RocaPiedra/RocBot/Diagrams/esp32-wroom-32d-usbc-pinout.png

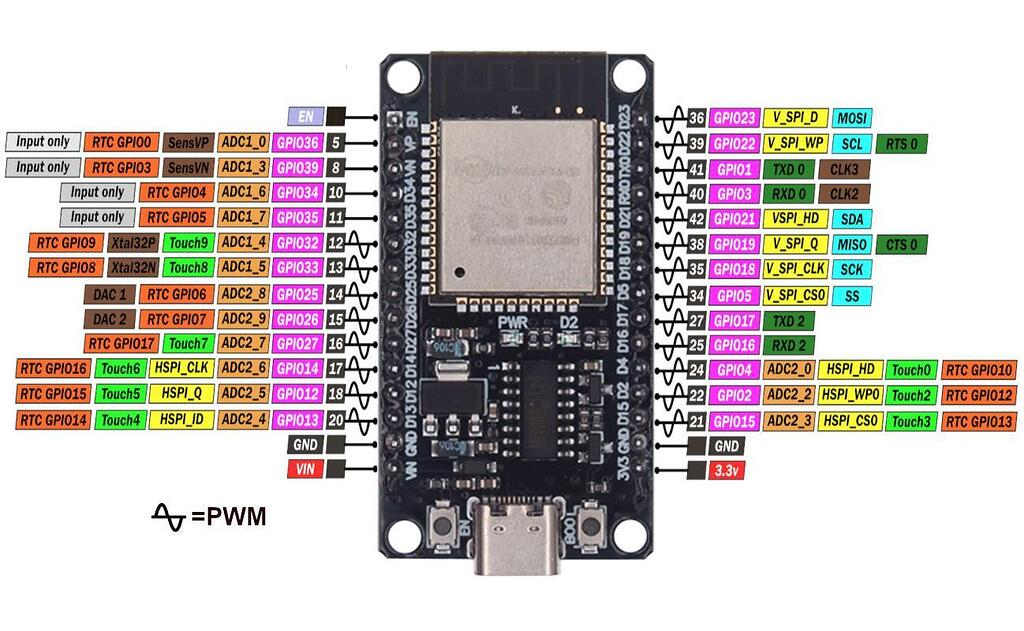
Diagrams/esp32-wroom-32d-usbc-pinout.png
