RocaPiedra/RocBot/Diagrams/L298N_conexiones.jpg

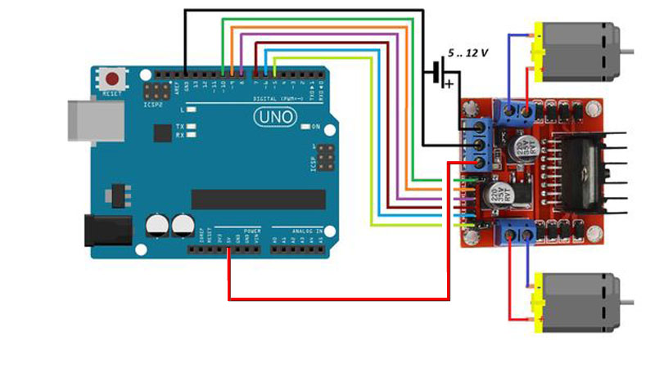
Diagrams/L298N_conexiones.jpg
