RocaPiedra/RocBot/Diagrams/L298N-Motor-Driver-Module-Pinout.png

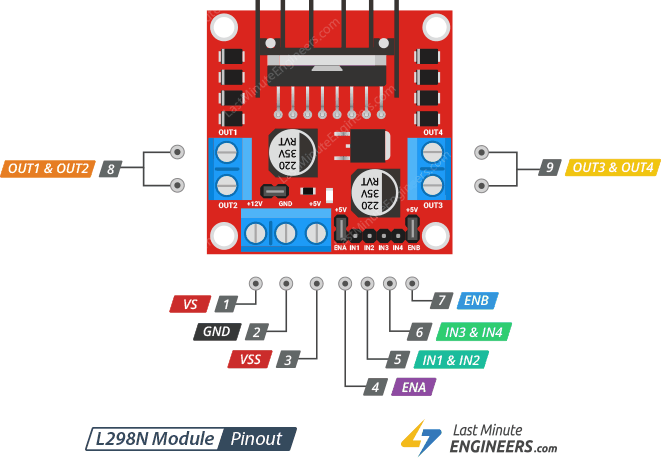
Diagrams/L298N-Motor-Driver-Module-Pinout.png
