RocaPiedra/RocBot/Diagrams/MotorWithEncoder.png

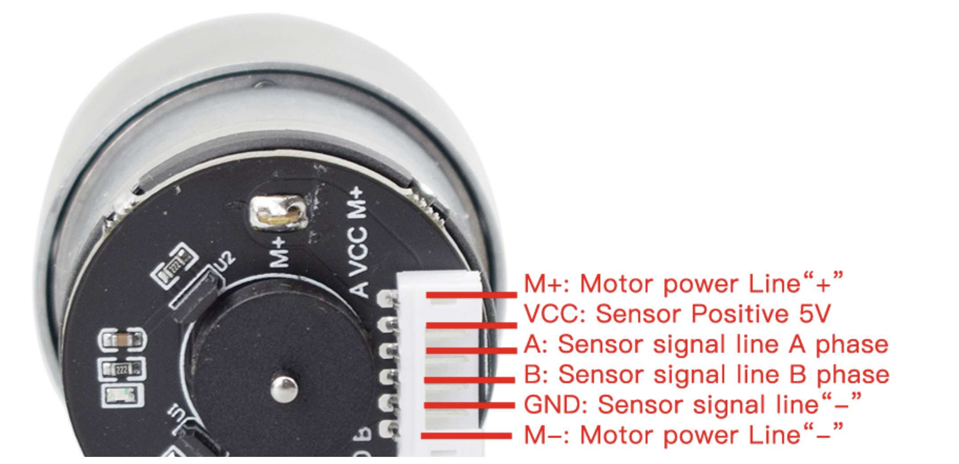
Diagrams/MotorWithEncoder.png
