RocaPiedra/RocBot/Tests/Motors/graphs/50HzRefreshRate.png

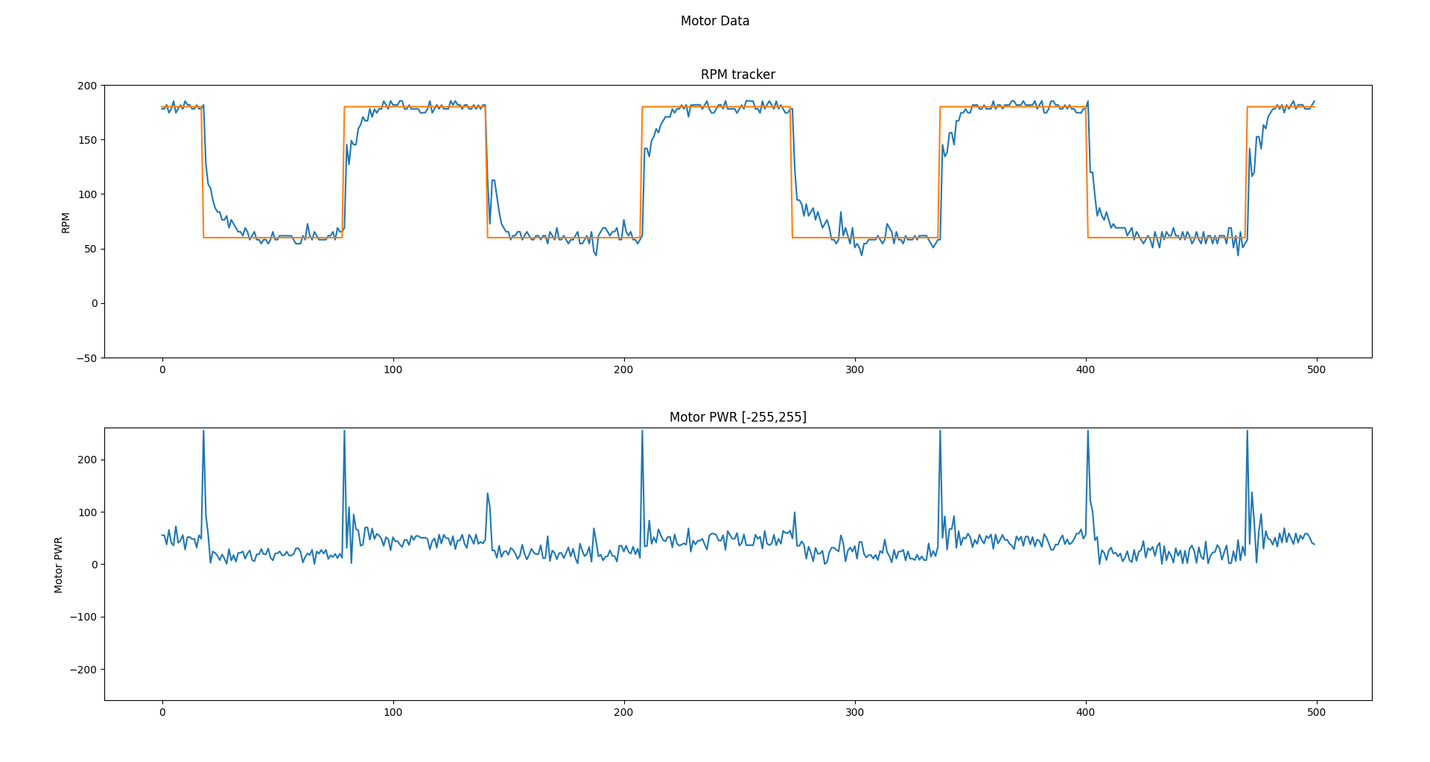
Tests/Motors/graphs/50HzRefreshRate.png
