RocaPiedra/RocBot/Tests/Motors/graphs/InputSignalInFunction.png

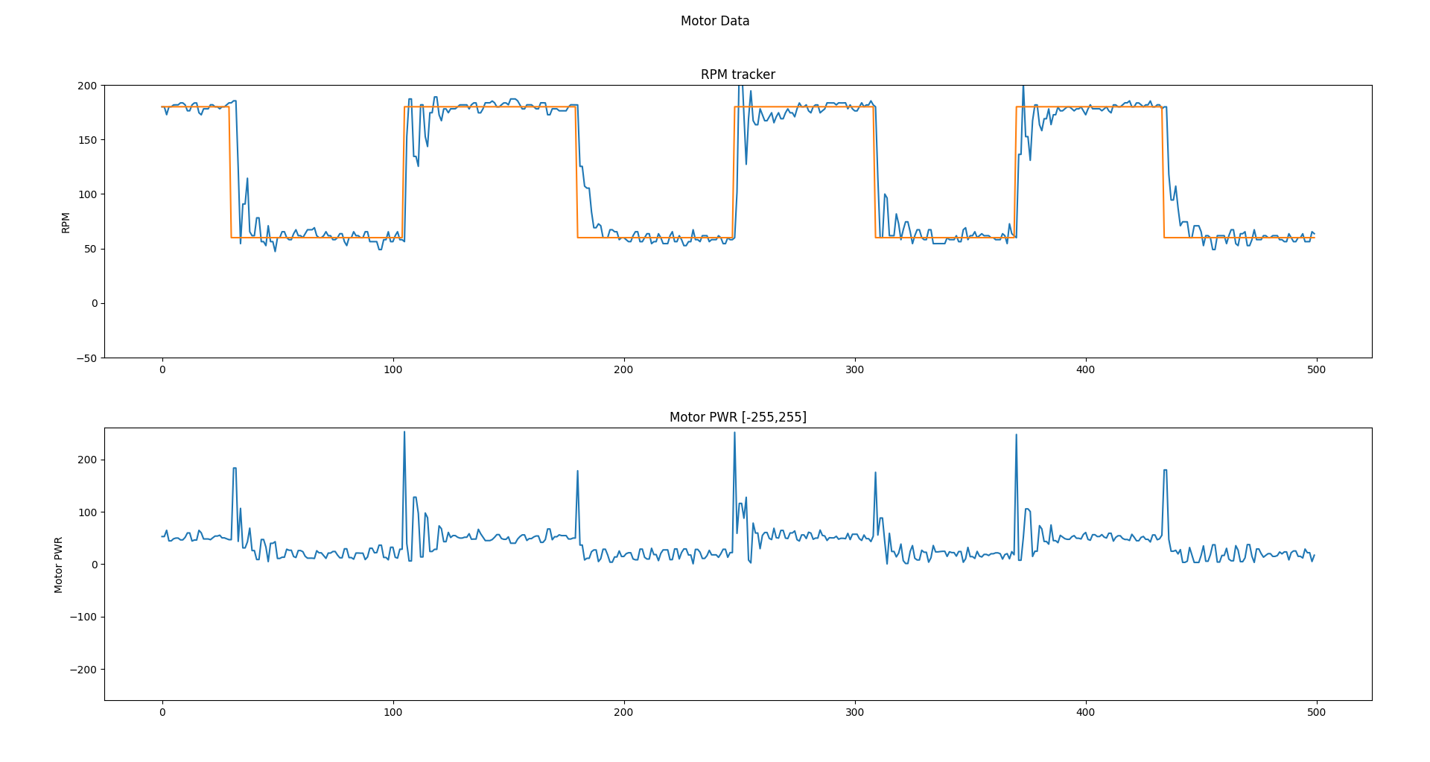
Tests/Motors/graphs/InputSignalInFunction.png
