RocaPiedra/RocBot/Tests/Motors/graphs/InputSignalInLoop.png

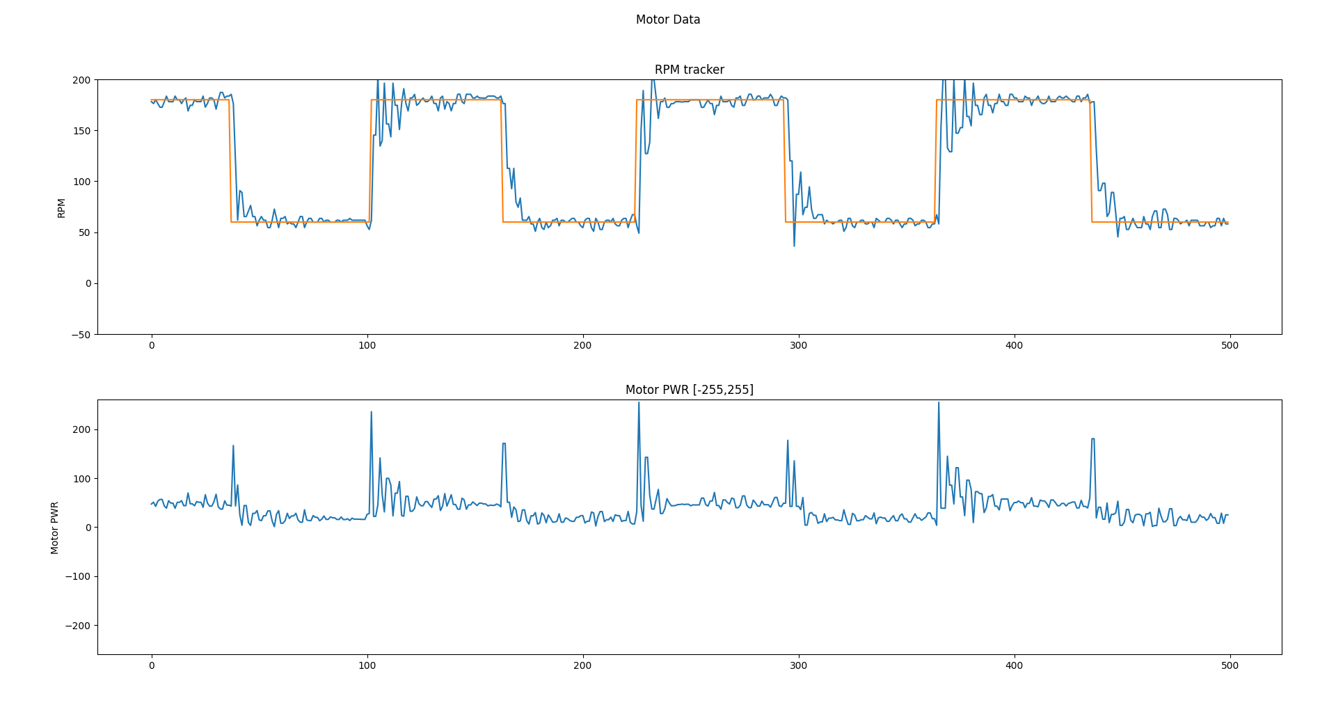
Tests/Motors/graphs/InputSignalInLoop.png
