RocaPiedra/RocBot/Tests/Motors/graphs/PID Calibration/kp0.8-ki1-kd0.1.png

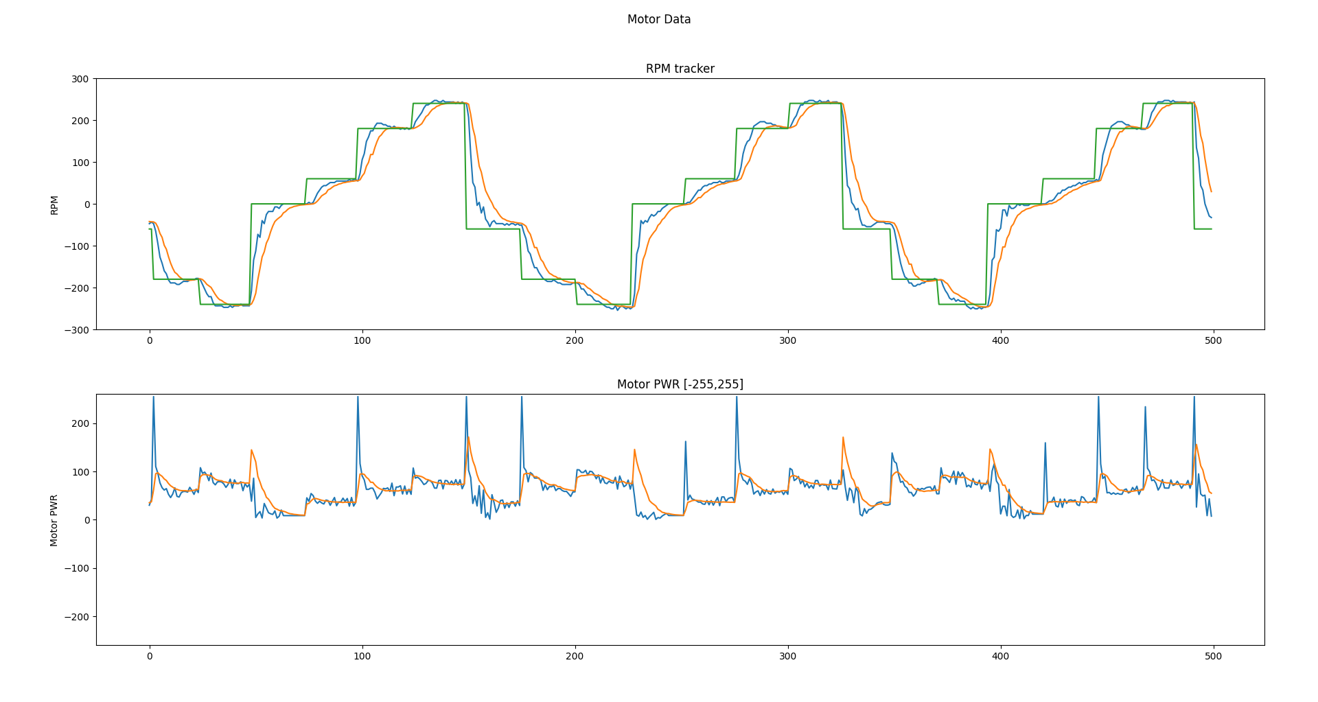
Tests/Motors/graphs/PID Calibration/kp0.8-ki1-kd0.1.png
