RocaPiedra/RocBot/Tests/Motors/graphs/PID Calibration/kp1-ki1-kd0.1.png

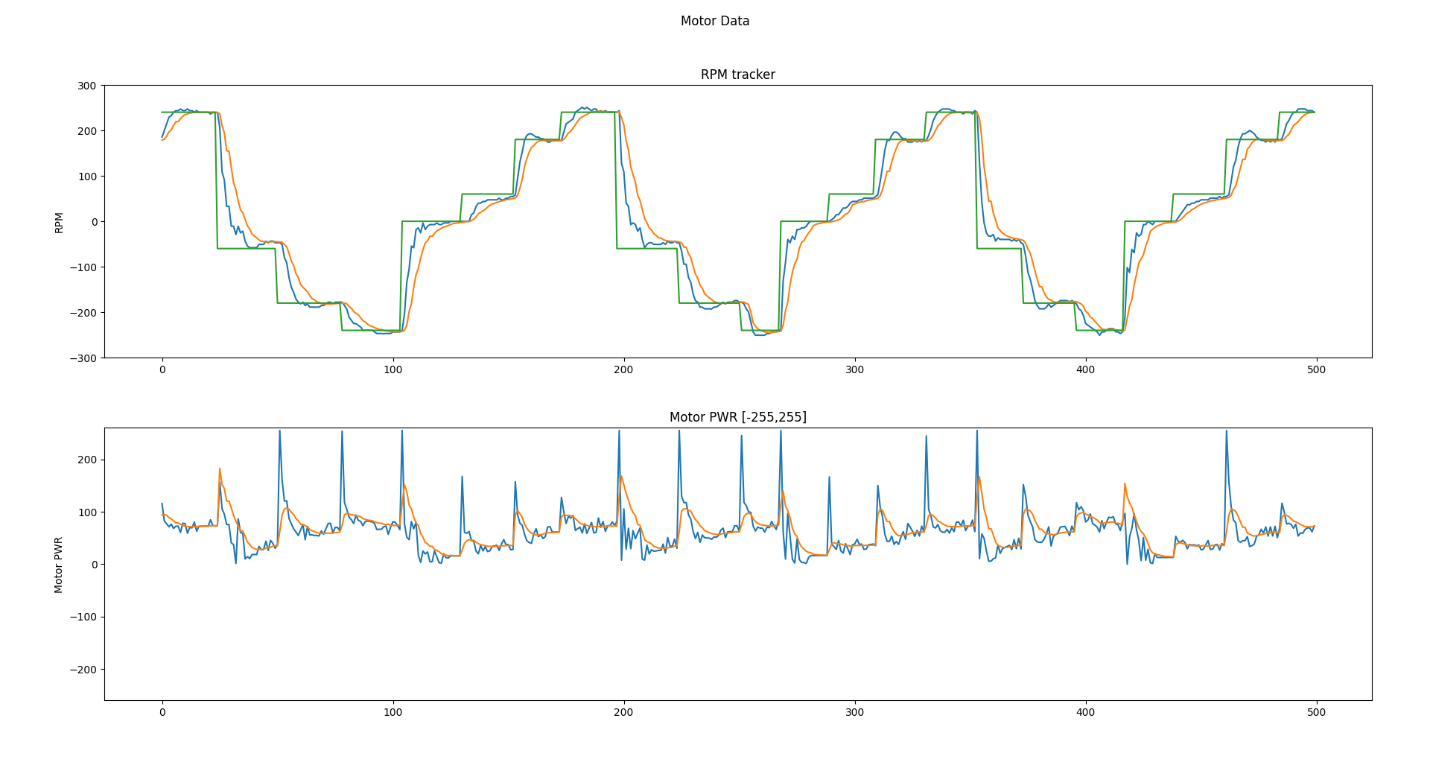
Tests/Motors/graphs/PID Calibration/kp1-ki1-kd0.1.png
