RocaPiedra/RocBot/Tests/Motors/graphs/PID Calibration/kp2-ki1-kd0.1.png

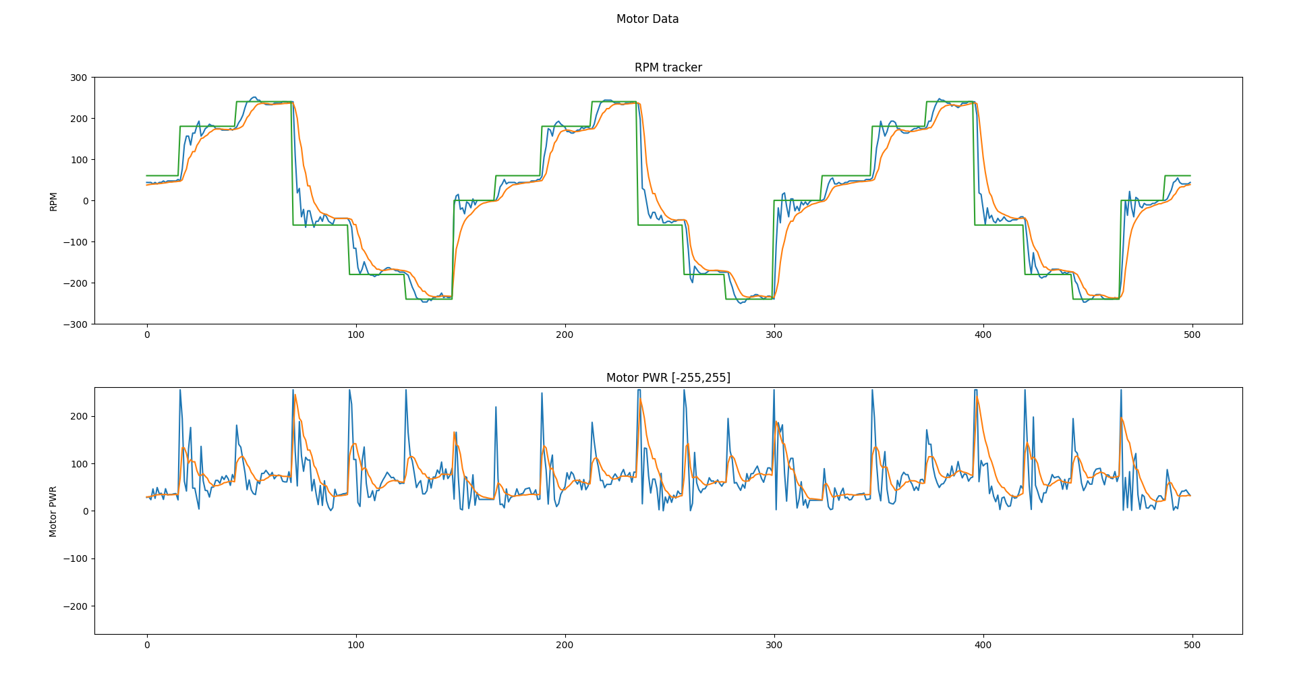
Tests/Motors/graphs/PID Calibration/kp2-ki1-kd0.1.png
