RocaPiedra/RocBot/Tests/Motors/graphs/pwr_rpm_filtered.png

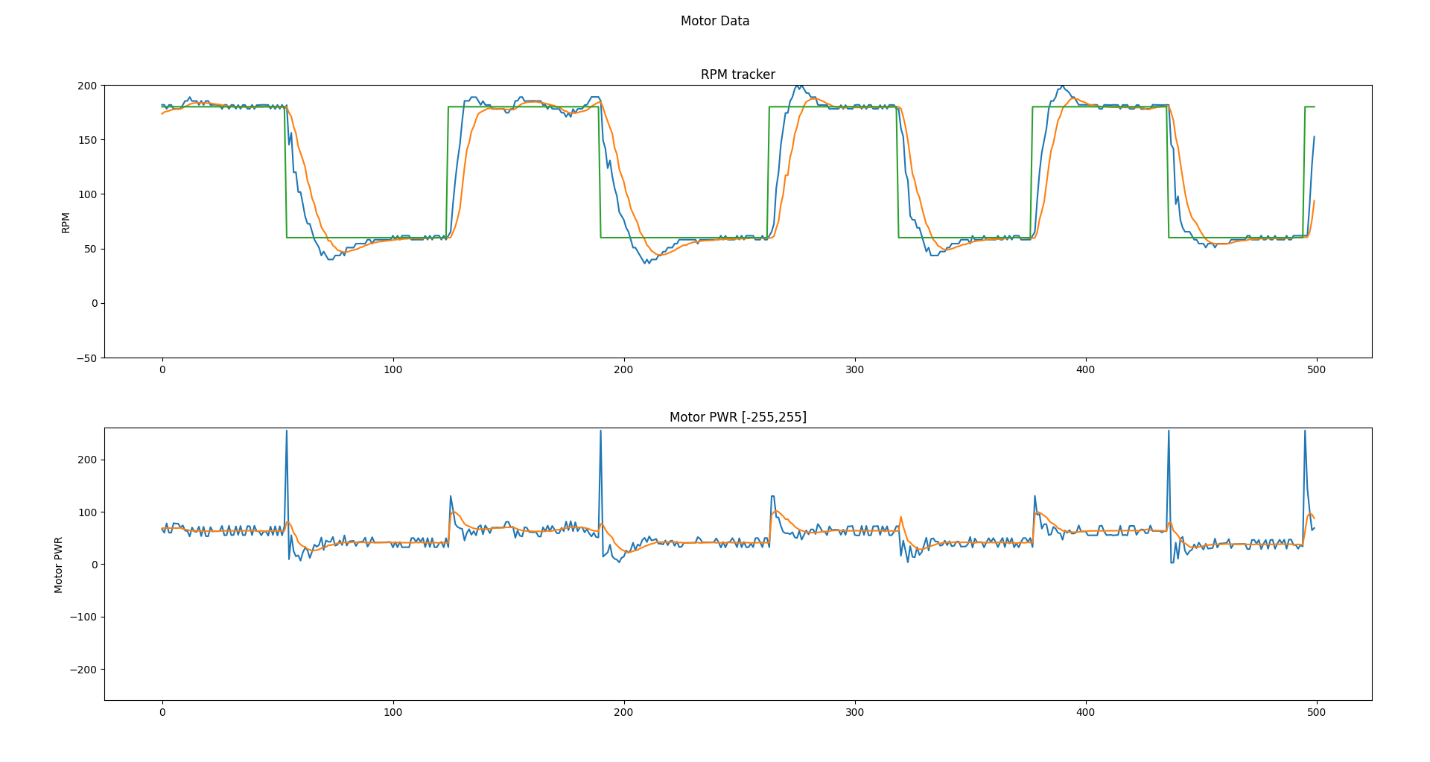
Tests/Motors/graphs/pwr_rpm_filtered.png
