RocaPiedra/RocBot/Tests/Motors/graphs/pwr_rpm_unfiltered.png

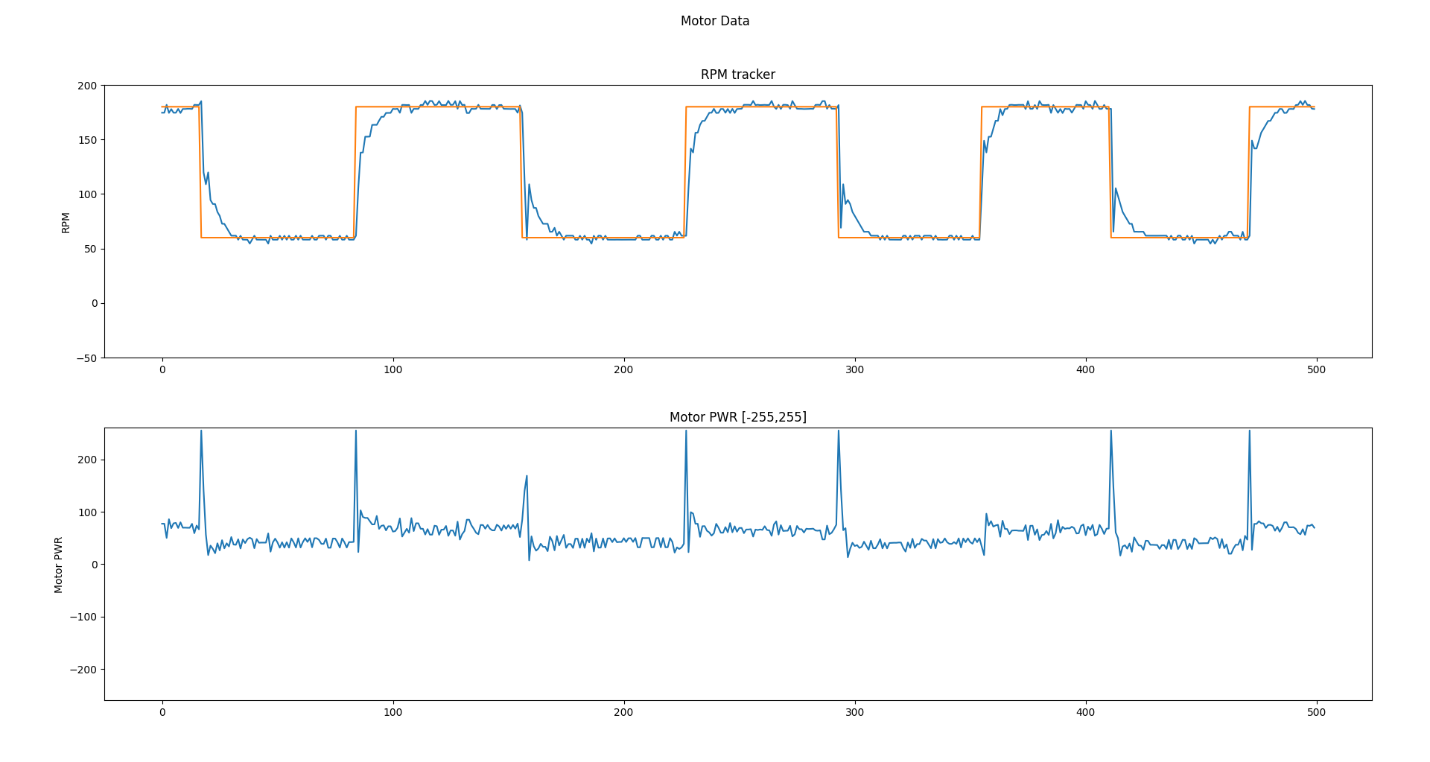
Tests/Motors/graphs/pwr_rpm_unfiltered.png
