RocaPiedra/RocBot/Tests/Motors/graphs/pwr_unfiltered_rpm_filtered.png

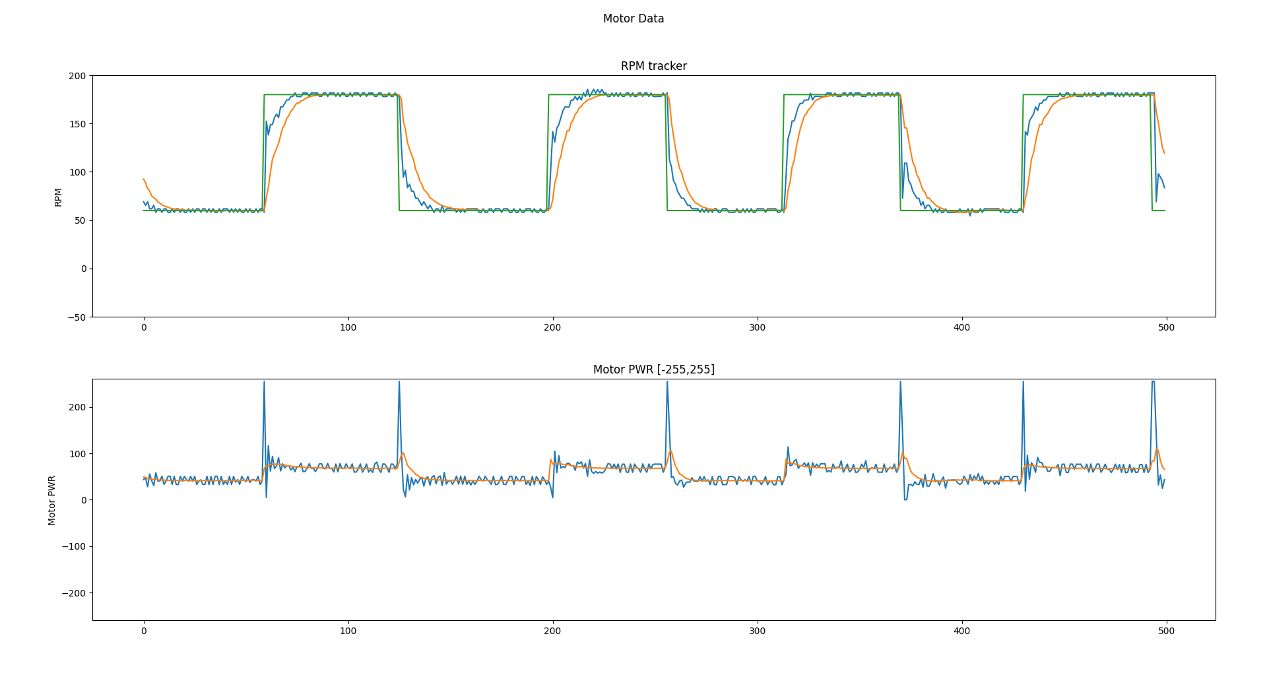
Tests/Motors/graphs/pwr_unfiltered_rpm_filtered.png
