RocaPiedra/RocBot/ESP32/ESP32WiFiConnect/src/main_microros.cpp

/*
 * RocBot ESP32 Motor Controller with micro-ROS (WiFi transport)
 *
 * Official micro_ros_platformio integration over WiFi/UDP.
 *
 * ROS 2 Topics:
 *   Subscribers:
 *     - /rocbot/motor_fl/target_rpm (std_msgs/Float64)
 *     - /rocbot/motor_fr/target_rpm (std_msgs/Float64)
 *     - /rocbot/motor_rl/target_rpm (std_msgs/Float64)
 *     - /rocbot/motor_rr/target_rpm (std_msgs/Float64)
 *     - /rocbot/motor_fl/target_pwm (std_msgs/Float64)   - Direct PWM (-255..255)
 *     - /rocbot/motor_fr/target_pwm (std_msgs/Float64)   - Direct PWM (-255..255)
 *     - /rocbot/motor_rl/target_pwm (std_msgs/Float64)   - Direct PWM (-255..255)
 *     - /rocbot/motor_rr/target_pwm (std_msgs/Float64)   - Direct PWM (-255..255)
 *     - /rocbot/command (std_msgs/String)
 *
 *   Publishers:
 *     - /rocbot/motor_fl/rpm (std_msgs/Float64)
 *     - /rocbot/motor_fl/pwm (std_msgs/Float64)
 *     - /rocbot/motor_fr/rpm (std_msgs/Float64)
 *     - /rocbot/motor_fr/pwm (std_msgs/Float64)
 *     - /rocbot/motor_rl/rpm (std_msgs/Float64)
 *     - /rocbot/motor_rl/pwm (std_msgs/Float64)
 *     - /rocbot/motor_rr/rpm (std_msgs/Float64)
 *     - /rocbot/motor_rr/pwm (std_msgs/Float64)
 *     - /rocbot/debug (std_msgs/String)
 *
 * Serial fallback: same commands as main_debug.cpp (local debug)
 *
 * Build:
 *   pio run -e microros -t upload    # Build and flash
 *   pio run -e microros --target clean_microros  # Force rebuild
 *
 * Agent (on host PC):
 *   docker run -it --rm --net=host microros/micro-ros-agent:humble udp4 --port 8888 -v6
 *
 * WiFi transport uses board_microros_transport = wifi in platformio.ini.
 * Update AGENT_IP in include/ssid.hpp to match your host PC's IP.
 */

#include <Arduino.h>
#include "MotorController.hpp"
#include "PIDClass.hpp"
#include "ssid.hpp"

// micro-ROS includes (provided by micro_ros_platformio)
#include <micro_ros_platformio.h>
#include <rcl/rcl.h>
#include <rclc/rclc.h>
#include <rclc/executor.h>
#include <std_msgs/msg/float64.h>
#include <std_msgs/msg/string.h>

// ============== Motor Configuration ==============
#define MAXCPR 330
#define MAXRPM 330
#define REFRESHRATE 5 // ms
#define NUMMOTORS 4   // FL, FR, RL, RR

#define AGENT_WAIT_MS 3000

// Pin assignments (ESP32) — see AGENTS.md
// L298N #1 (front): FL + FR | L298N #2 (rear): RL + RR
MotorController MotorFL("FL", 32, 35, 34, 33, 25, 1.0, 0.0, 0.0);
MotorController MotorFR("FR", 14, 22, 23, 27, 26, 1.0, 0.0, 0.0);
MotorController MotorRL("RL", 13, 16, 17, 4, 5, 1.0, 0.0, 0.0);
MotorController MotorRR("RR", 18, 36, 39, 19, 21, 1.0, 0.0, 0.0);

MotorController* motors[NUMMOTORS] = {&MotorFL, &MotorFR, &MotorRL, &MotorRR};

long prevT[NUMMOTORS] = {0, 0, 0, 0};
int target_value = 0;
bool pid_enabled = false;
bool direct_mode = false;
int direct_pwm = 0;
bool reverse_direct = false;

// Test mode
bool step_test_mode = false;
unsigned long step_test_start = 0;
int step_test_target = 0;

unsigned long lastDebugPrint = 0;
unsigned long debugPrintInterval = 100;

volatile unsigned long encFR_interrupts = 0;
volatile unsigned long encFL_interrupts = 0;
volatile unsigned long encRL_interrupts = 0;
volatile unsigned long encRR_interrupts = 0;

bool microros_connected = false;
unsigned long last_agent_check = 0;

// ============== ISR Handlers ==============
void IRAM_ATTR ISRReadEncoderFR() {
    MotorFR.readEncoder();
    encFR_interrupts++;
}

void IRAM_ATTR ISRReadEncoderFL() {
    MotorFL.readEncoder();
    encFL_interrupts++;
}

void IRAM_ATTR ISRReadEncoderRL() {
    MotorRL.readEncoder();
    encRL_interrupts++;
}

void IRAM_ATTR ISRReadEncoderRR() {
    MotorRR.readEncoder();
    encRR_interrupts++;
}

// ============== micro-ROS Variables ==============
rcl_node_t node;
rclc_executor_t executor;
rclc_support_t support;
rcl_allocator_t allocator;

// Subscribers
rcl_subscription_t sub_fl_target;
rcl_subscription_t sub_fr_target;
rcl_subscription_t sub_rl_target;
rcl_subscription_t sub_rr_target;
rcl_subscription_t sub_fl_pwm_cmd;
rcl_subscription_t sub_fr_pwm_cmd;
rcl_subscription_t sub_rl_pwm_cmd;
rcl_subscription_t sub_rr_pwm_cmd;
rcl_subscription_t sub_command;

// Publishers (using simple Float64 instead of Float64MultiArray for ESP32 reliability)
rcl_publisher_t pub_fl_rpm;
rcl_publisher_t pub_fl_pwm;
rcl_publisher_t pub_fr_rpm;
rcl_publisher_t pub_fr_pwm;
rcl_publisher_t pub_rl_rpm;
rcl_publisher_t pub_rl_pwm;
rcl_publisher_t pub_rr_rpm;
rcl_publisher_t pub_rr_pwm;
rcl_publisher_t pub_debug;

// Messages
std_msgs__msg__Float64 msg_fl_rpm;
std_msgs__msg__Float64 msg_fl_pwm;
std_msgs__msg__Float64 msg_fr_rpm;
std_msgs__msg__Float64 msg_fr_pwm;
std_msgs__msg__Float64 msg_rl_rpm;
std_msgs__msg__Float64 msg_rl_pwm;
std_msgs__msg__Float64 msg_rr_rpm;
std_msgs__msg__Float64 msg_rr_pwm;
std_msgs__msg__String msg_command;
std_msgs__msg__String msg_debug;
std_msgs__msg__Float64 msg_fl_target;
std_msgs__msg__Float64 msg_fr_target;
std_msgs__msg__Float64 msg_rl_target;
std_msgs__msg__Float64 msg_rr_target;
std_msgs__msg__Float64 msg_fl_pwm_cmd;
std_msgs__msg__Float64 msg_fr_pwm_cmd;
std_msgs__msg__Float64 msg_rl_pwm_cmd;
std_msgs__msg__Float64 msg_rr_pwm_cmd;

// State buffers
char debug_buffer[768];
char command_buffer[256];

// Incoming ROS targets
float ros_target_fl = 0.0;
float ros_target_fr = 0.0;
float ros_target_rl = 0.0;
float ros_target_rr = 0.0;
bool ros_targets_active = false;

// Per-motor direct PWM (from ROS topics)
int direct_pwm_fl = 0;
int direct_pwm_fr = 0;
int direct_pwm_rl = 0;
int direct_pwm_rr = 0;
bool direct_mode_fl = false;
bool direct_mode_fr = false;
bool direct_mode_rl = false;
bool direct_mode_rr = false;
bool reverse_direct_fl = false;
bool reverse_direct_fr = false;
bool reverse_direct_rl = false;
bool reverse_direct_rr = false;

void clearPerMotorDirect() {
    direct_mode_fl = false; direct_mode_fr = false;
    direct_mode_rl = false; direct_mode_rr = false;
}

// ============== Serial Input (same as main_debug.cpp) ==============
void readSerialInput() {
    if (Serial.available() > 0) {
        String input = Serial.readStringUntil('\n');
        input.trim();

        if (input.length() == 0) return;

        char firstChar = input.charAt(0);

        if (input.startsWith("kp")) {
            float val = input.substring(2).toFloat();
            for (int i = 0; i < NUMMOTORS; i++) motors[i]->PID.kp = val;
            Serial.print("Kp set to: "); Serial.println(val);
            return;
        }
        if (input.startsWith("ki")) {
            float val = input.substring(2).toFloat();
            for (int i = 0; i < NUMMOTORS; i++) motors[i]->PID.ki = val;
            Serial.print("Ki set to: "); Serial.println(val);
            return;
        }
        if (input.startsWith("kd")) {
            float val = input.substring(2).toFloat();
            for (int i = 0; i < NUMMOTORS; i++) motors[i]->PID.kd = val;
            Serial.print("Kd set to: "); Serial.println(val);
            return;
        }
        if (input.startsWith("os")) {
            float val = input.substring(2).toFloat();
            for (int i = 0; i < NUMMOTORS; i++) motors[i]->PID.output_scale = val;
            Serial.print("Output scale set to: "); Serial.println(val);
            return;
        }
        if (input.startsWith("step")) {
            int val = input.substring(4).toInt();
            step_test_mode = true;
            step_test_target = val;
            step_test_start = millis();
            target_value = 0;
            pid_enabled = true;
            direct_mode = false;
            clearPerMotorDirect();
            Serial.print("Step test starting: target "); Serial.println(val);
            return;
        }

        switch(firstChar) {
            case 'g': {
                Serial.println("--- MOTOR STATE ---");
                Serial.print("Kp="); Serial.print(motors[0]->PID.kp);
                Serial.print(" Ki="); Serial.print(motors[0]->PID.ki);
                Serial.print(" Kd="); Serial.println(motors[0]->PID.kd);
                for(int id = 0; id < NUMMOTORS; id++) {
                    Serial.println(motors[id]->GetMotorState());
                }
                break;
            }
            case 'd': {
                int pwm = input.substring(1).toInt();
                pwm = constrain(pwm, 0, 255);
                direct_mode = true; pid_enabled = false; step_test_mode = false;
                reverse_direct = false; direct_pwm = pwm;
                clearPerMotorDirect();
                Serial.print("Direct PWM FORWARD: "); Serial.println(direct_pwm);
                break;
            }
            case 'D': {
                int pwm = input.substring(1).toInt();
                pwm = constrain(pwm, 0, 255);
                direct_mode = true; pid_enabled = false; step_test_mode = false;
                reverse_direct = true; direct_pwm = pwm;
                clearPerMotorDirect();
                Serial.print("Direct PWM REVERSE: "); Serial.println(direct_pwm);
                break;
            }
            case 'e': {
                Serial.println("--- ENCODER DEBUG ---");
                Serial.print("FR: pulses="); Serial.print(MotorFR.GetPulses());
                Serial.print(", ENCB="); Serial.print(digitalRead(MotorFR.EncBPin));
                Serial.print(", interrupts="); Serial.println(encFR_interrupts);
                Serial.print("FL: pulses="); Serial.print(MotorFL.GetPulses());
                Serial.print(", ENCB="); Serial.print(digitalRead(MotorFL.EncBPin));
                Serial.print(", interrupts="); Serial.println(encFL_interrupts);
                Serial.print("RR: pulses="); Serial.print(MotorRR.GetPulses());
                Serial.print(", ENCB="); Serial.print(digitalRead(MotorRR.EncBPin));
                Serial.print(", interrupts="); Serial.println(encRR_interrupts);
                Serial.print("RL: pulses="); Serial.print(MotorRL.GetPulses());
                Serial.print(", ENCB="); Serial.print(digitalRead(MotorRL.EncBPin));
                Serial.print(", interrupts="); Serial.println(encRL_interrupts);
                break;
            }
            case 'p': {
                pid_enabled = true; direct_mode = false; step_test_mode = false;
                clearPerMotorDirect();
                Serial.println("PID mode enabled");
                Serial.print("Current PID: Kp="); Serial.print(motors[0]->PID.kp);
                Serial.print(" Ki="); Serial.print(motors[0]->PID.ki);
                Serial.print(" Kd="); Serial.println(motors[0]->PID.kd);
                break;
            }
            case 's': {
                pid_enabled = false; direct_mode = false; step_test_mode = false;
                clearPerMotorDirect();
                target_value = 0;
                for(int id = 0; id < NUMMOTORS; id++) motors[id]->stop();
                Serial.println("Motors stopped");
                break;
            }
            default: {
                int rpm_val = input.toInt();
                if (input.length() > 0 && (isdigit(input.charAt(0)) || input.charAt(0) == '-')) {
                    rpm_val = constrain(rpm_val, -MAXRPM, MAXRPM);
                    target_value = rpm_val;
                    pid_enabled = true; direct_mode = false; step_test_mode = false;
                    clearPerMotorDirect();
                    Serial.print("Target RPM set to: "); Serial.println(target_value);
                }
                break;
            }
        }
    }
}

// ============== ROS Subscriber Callbacks ==============
void sub_fl_callback(const void *msg_in) {
    const std_msgs__msg__Float64 *msg = (const std_msgs__msg__Float64 *)msg_in;
    ros_target_fl = (float)msg->data;
    ros_targets_active = true;
}

void sub_fr_callback(const void *msg_in) {
    const std_msgs__msg__Float64 *msg = (const std_msgs__msg__Float64 *)msg_in;
    ros_target_fr = (float)msg->data;
    ros_targets_active = true;
}

void sub_rl_callback(const void *msg_in) {
    const std_msgs__msg__Float64 *msg = (const std_msgs__msg__Float64 *)msg_in;
    ros_target_rl = (float)msg->data;
    ros_targets_active = true;
}

void sub_rr_callback(const void *msg_in) {
    const std_msgs__msg__Float64 *msg = (const std_msgs__msg__Float64 *)msg_in;
    ros_target_rr = (float)msg->data;
    ros_targets_active = true;
}

void sub_fl_pwm_cmd_callback(const void *msg_in) {
    const std_msgs__msg__Float64 *msg = (const std_msgs__msg__Float64 *)msg_in;
    float pwm = (float)msg->data;
    if (pwm == 0) {
        direct_mode_fl = false;
        motors[0]->stop();
    } else {
        direct_mode_fl = true;
        pid_enabled = false; step_test_mode = false;
        reverse_direct_fl = (pwm < 0);
        direct_pwm_fl = (int)constrain(abs((int)pwm), 0, 255);
    }
}

void sub_fr_pwm_cmd_callback(const void *msg_in) {
    const std_msgs__msg__Float64 *msg = (const std_msgs__msg__Float64 *)msg_in;
    float pwm = (float)msg->data;
    if (pwm == 0) {
        direct_mode_fr = false;
        motors[1]->stop();
    } else {
        direct_mode_fr = true;
        pid_enabled = false; step_test_mode = false;
        reverse_direct_fr = (pwm < 0);
        direct_pwm_fr = (int)constrain(abs((int)pwm), 0, 255);
    }
}

void sub_rl_pwm_cmd_callback(const void *msg_in) {
    const std_msgs__msg__Float64 *msg = (const std_msgs__msg__Float64 *)msg_in;
    float pwm = (float)msg->data;
    if (pwm == 0) {
        direct_mode_rl = false;
        motors[2]->stop();
    } else {
        direct_mode_rl = true;
        pid_enabled = false; step_test_mode = false;
        reverse_direct_rl = (pwm < 0);
        direct_pwm_rl = (int)constrain(abs((int)pwm), 0, 255);
    }
}

void sub_rr_pwm_cmd_callback(const void *msg_in) {
    const std_msgs__msg__Float64 *msg = (const std_msgs__msg__Float64 *)msg_in;
    float pwm = (float)msg->data;
    if (pwm == 0) {
        direct_mode_rr = false;
        motors[3]->stop();
    } else {
        direct_mode_rr = true;
        pid_enabled = false; step_test_mode = false;
        reverse_direct_rr = (pwm < 0);
        direct_pwm_rr = (int)constrain(abs((int)pwm), 0, 255);
    }
}

void sub_command_callback(const void *msg_in) {
    const std_msgs__msg__String *msg = (const std_msgs__msg__String *)msg_in;
    // micro-ROS does not null-terminate the static string buffer, so
    // terminate it explicitly (capacity 256 always leaves room for it).
    size_t cmd_len = msg->data.size;
    if (cmd_len >= sizeof(command_buffer)) cmd_len = sizeof(command_buffer) - 1;
    command_buffer[cmd_len] = '\0';
    String cmd = String(command_buffer);
    cmd.trim();

    if (cmd.startsWith("kp")) {
        float val = cmd.substring(2).toFloat();
        for (int i = 0; i < NUMMOTORS; i++) motors[i]->PID.kp = val;
    } else if (cmd.startsWith("ki")) {
        float val = cmd.substring(2).toFloat();
        for (int i = 0; i < NUMMOTORS; i++) motors[i]->PID.ki = val;
    } else if (cmd.startsWith("kd")) {
        float val = cmd.substring(2).toFloat();
        for (int i = 0; i < NUMMOTORS; i++) motors[i]->PID.kd = val;
    } else if (cmd.startsWith("os")) {
        float val = cmd.substring(2).toFloat();
        for (int i = 0; i < NUMMOTORS; i++) motors[i]->PID.output_scale = val;
    } else if (cmd.startsWith("step")) {
        int val = cmd.substring(4).toInt();
        step_test_mode = true;
        step_test_target = val;
        step_test_start = millis();
        target_value = 0;
        pid_enabled = true;
        direct_mode = false; clearPerMotorDirect();
    } else if (cmd == "p") {
        pid_enabled = true; direct_mode = false; step_test_mode = false;
        clearPerMotorDirect();
    } else if (cmd == "s") {
        pid_enabled = false; direct_mode = false; step_test_mode = false;
        clearPerMotorDirect();
        target_value = 0;
        for(int id = 0; id < NUMMOTORS; id++) motors[id]->stop();
    } else if (cmd.startsWith("d")) {
        int pwm = cmd.substring(1).toInt();
        pwm = constrain(pwm, 0, 255);
        direct_mode = true; pid_enabled = false; step_test_mode = false;
        reverse_direct = false; direct_pwm = pwm;
        clearPerMotorDirect();
    } else if (cmd.startsWith("D")) {
        int pwm = cmd.substring(1).toInt();
        pwm = constrain(pwm, 0, 255);
        direct_mode = true; pid_enabled = false; step_test_mode = false;
        reverse_direct = true; direct_pwm = pwm;
        clearPerMotorDirect();
    } else {
        int rpm_val = cmd.toInt();
        if (cmd.length() > 0 && (isdigit(cmd.charAt(0)) || cmd.charAt(0) == '-')) {
            target_value = constrain(rpm_val, -MAXRPM, MAXRPM);
            pid_enabled = true; direct_mode = false; step_test_mode = false;
            clearPerMotorDirect();
        }
    }
}

// ============== Forward Declarations ==============
void publish_motor_states();
void publish_debug_string();

// ============== Debug Output (serial + ROS) ==============
void printDebugInfo() {
    if (millis() - lastDebugPrint < debugPrintInterval) return;
    lastDebugPrint = millis();

    // --- Serial output ---
    Serial.print("--- DEBUG T:");
    Serial.print(millis());
    Serial.print(" ---");

    if (step_test_mode) {
        Serial.print(" STEP_TEST->"); Serial.print(step_test_target);
    } else if (direct_mode || direct_mode_fl || direct_mode_fr || direct_mode_rl || direct_mode_rr) {
        Serial.print(" DIRECT:");
        Serial.print(reverse_direct ? "REV " : "FWD ");
        Serial.print(direct_pwm);
        if (direct_mode_fl) { Serial.print(" FL:"); Serial.print(direct_pwm_fl); }
        if (direct_mode_fr) { Serial.print(" FR:"); Serial.print(direct_pwm_fr); }
        if (direct_mode_rl) { Serial.print(" RL:"); Serial.print(direct_pwm_rl); }
        if (direct_mode_rr) { Serial.print(" RR:"); Serial.print(direct_pwm_rr); }
    } else if (pid_enabled) {
        Serial.print(" PID");
    } else {
        Serial.print(" STOP");
    }

    Serial.print(" Tgt:"); Serial.print(target_value);
    Serial.print(" Kp:"); Serial.print(motors[0]->PID.kp, 2);
    Serial.print(" Ki:"); Serial.print(motors[0]->PID.ki, 2);
    Serial.print(" Kd:"); Serial.print(motors[0]->PID.kd, 2);
    Serial.print(" | ");

    for(int id = 0; id < NUMMOTORS; id++) {
        MotorController* m = motors[id];

        Serial.print(m->motorPos);
        Serial.print(" RPM:"); Serial.print(m->CurrentRPM, 1);
        Serial.print(" F:"); Serial.print(m->FilteredRPM, 1);
        Serial.print(" PWM:"); Serial.print(m->PID.pwr_filt, 1);
        Serial.print(" Out:"); Serial.print(m->PID.pwr, 1);

        int in1 = digitalRead(m->In1Pin);
        int in2 = digitalRead(m->In2Pin);
        Serial.print(" Dir:");
        if (in1 == HIGH && in2 == LOW) Serial.print("FWD");
        else if (in1 == LOW && in2 == HIGH) Serial.print("REV");
        else Serial.print("STP");
        Serial.print(" Pulses:"); Serial.print(String(m->GetPulses()));
        Serial.print(" | ");
    }
    Serial.println();

    // --- ROS publish (same data, same rate) ---
    if (microros_connected) {
        publish_motor_states();
        publish_debug_string();
    }
}

// ============== micro-ROS Setup (Official API) ==============
void setup_micro_ros() {
    // Set up WiFi transport (board_microros_transport = wifi in platformio.ini)
    set_microros_wifi_transports((char*)WIFI_SSID_1, (char*)WIFI_PASSWORD, AGENT_IP_ADDRESS, AGENT_PORT);

    allocator = rcl_get_default_allocator();

    // Wait briefly for agent to be ready
    Serial.println("[ROS] Waiting for agent...");
    delay(AGENT_WAIT_MS);

    // Initialize support with error checking
    rcl_ret_t ret = rclc_support_init(&support, 0, NULL, &allocator);
    if (ret != RCL_RET_OK) {
        Serial.println("Failed to init micro-ROS support!");
        microros_connected = false;
        return;
    }

    ret = rclc_node_init_default(&node, "rocbot_motor_controller", "", &support);
    if (ret != RCL_RET_OK) {
        Serial.println("Failed to init micro-ROS node!");
        rclc_support_fini(&support);
        microros_connected = false;
        return;
    }

    // 10 handles: 9 subs (4 target_rpm + 4 target_pwm + 1 command) + 1 spare
    // (publishers need no executor handles)
    rclc_executor_init(&executor, &support.context, 10, &allocator);

    // --- Subscribers ---
    rclc_subscription_init_default(&sub_fl_target, &node,
        ROSIDL_GET_MSG_TYPE_SUPPORT(std_msgs, msg, Float64), "rocbot/motor_fl/target_rpm");
    rclc_subscription_init_default(&sub_fr_target, &node,
        ROSIDL_GET_MSG_TYPE_SUPPORT(std_msgs, msg, Float64), "rocbot/motor_fr/target_rpm");
    rclc_subscription_init_default(&sub_rl_target, &node,
        ROSIDL_GET_MSG_TYPE_SUPPORT(std_msgs, msg, Float64), "rocbot/motor_rl/target_rpm");
    rclc_subscription_init_default(&sub_rr_target, &node,
        ROSIDL_GET_MSG_TYPE_SUPPORT(std_msgs, msg, Float64), "rocbot/motor_rr/target_rpm");
    rclc_subscription_init_default(&sub_fl_pwm_cmd, &node,
        ROSIDL_GET_MSG_TYPE_SUPPORT(std_msgs, msg, Float64), "rocbot/motor_fl/target_pwm");
    rclc_subscription_init_default(&sub_fr_pwm_cmd, &node,
        ROSIDL_GET_MSG_TYPE_SUPPORT(std_msgs, msg, Float64), "rocbot/motor_fr/target_pwm");
    rclc_subscription_init_default(&sub_rl_pwm_cmd, &node,
        ROSIDL_GET_MSG_TYPE_SUPPORT(std_msgs, msg, Float64), "rocbot/motor_rl/target_pwm");
    rclc_subscription_init_default(&sub_rr_pwm_cmd, &node,
        ROSIDL_GET_MSG_TYPE_SUPPORT(std_msgs, msg, Float64), "rocbot/motor_rr/target_pwm");
    rclc_subscription_init_default(&sub_command, &node,
        ROSIDL_GET_MSG_TYPE_SUPPORT(std_msgs, msg, String), "rocbot/command");

    rclc_executor_add_subscription(&executor, &sub_fl_target, &msg_fl_target, &sub_fl_callback, ON_NEW_DATA);
    rclc_executor_add_subscription(&executor, &sub_fr_target, &msg_fr_target, &sub_fr_callback, ON_NEW_DATA);
    rclc_executor_add_subscription(&executor, &sub_rl_target, &msg_rl_target, &sub_rl_callback, ON_NEW_DATA);
    rclc_executor_add_subscription(&executor, &sub_rr_target, &msg_rr_target, &sub_rr_callback, ON_NEW_DATA);
    rclc_executor_add_subscription(&executor, &sub_fl_pwm_cmd, &msg_fl_pwm_cmd, &sub_fl_pwm_cmd_callback, ON_NEW_DATA);
    rclc_executor_add_subscription(&executor, &sub_fr_pwm_cmd, &msg_fr_pwm_cmd, &sub_fr_pwm_cmd_callback, ON_NEW_DATA);
    rclc_executor_add_subscription(&executor, &sub_rl_pwm_cmd, &msg_rl_pwm_cmd, &sub_rl_pwm_cmd_callback, ON_NEW_DATA);
    rclc_executor_add_subscription(&executor, &sub_rr_pwm_cmd, &msg_rr_pwm_cmd, &sub_rr_pwm_cmd_callback, ON_NEW_DATA);
    rclc_executor_add_subscription(&executor, &sub_command, &msg_command, &sub_command_callback, ON_NEW_DATA);

    // --- Publishers (using simple Float64 for ESP32 reliability) ---
    rclc_publisher_init_default(&pub_fl_rpm, &node,
        ROSIDL_GET_MSG_TYPE_SUPPORT(std_msgs, msg, Float64), "rocbot/motor_fl/rpm");
    rclc_publisher_init_default(&pub_fl_pwm, &node,
        ROSIDL_GET_MSG_TYPE_SUPPORT(std_msgs, msg, Float64), "rocbot/motor_fl/pwm");
    rclc_publisher_init_default(&pub_fr_rpm, &node,
        ROSIDL_GET_MSG_TYPE_SUPPORT(std_msgs, msg, Float64), "rocbot/motor_fr/rpm");
    rclc_publisher_init_default(&pub_fr_pwm, &node,
        ROSIDL_GET_MSG_TYPE_SUPPORT(std_msgs, msg, Float64), "rocbot/motor_fr/pwm");
    rclc_publisher_init_default(&pub_rl_rpm, &node,
        ROSIDL_GET_MSG_TYPE_SUPPORT(std_msgs, msg, Float64), "rocbot/motor_rl/rpm");
    rclc_publisher_init_default(&pub_rl_pwm, &node,
        ROSIDL_GET_MSG_TYPE_SUPPORT(std_msgs, msg, Float64), "rocbot/motor_rl/pwm");
    rclc_publisher_init_default(&pub_rr_rpm, &node,
        ROSIDL_GET_MSG_TYPE_SUPPORT(std_msgs, msg, Float64), "rocbot/motor_rr/rpm");
    rclc_publisher_init_default(&pub_rr_pwm, &node,
        ROSIDL_GET_MSG_TYPE_SUPPORT(std_msgs, msg, Float64), "rocbot/motor_rr/pwm");
    rclc_publisher_init_default(&pub_debug, &node,
        ROSIDL_GET_MSG_TYPE_SUPPORT(std_msgs, msg, String), "rocbot/debug");

    // Init string message buffers
    msg_command.data.data = command_buffer;
    msg_command.data.size = 0;
    msg_command.data.capacity = sizeof(command_buffer);

    msg_debug.data.data = debug_buffer;
    msg_debug.data.size = 0;
    msg_debug.data.capacity = sizeof(debug_buffer);

    microros_connected = true;
    Serial.println("micro-ROS initialized successfully!");
}

void publish_motor_states() {
    // FL RPM
    msg_fl_rpm.data = MotorFL.CurrentRPM;
    (void)rcl_publish(&pub_fl_rpm, &msg_fl_rpm, NULL);

    // FL PWM: publish actual applied speed in direct mode, PID filtered output otherwise
    if (direct_mode || direct_mode_fl) {
        msg_fl_pwm.data = MotorFL.currentSpeed;
    } else {
        msg_fl_pwm.data = MotorFL.PID.pwr_filt;
    }
    (void)rcl_publish(&pub_fl_pwm, &msg_fl_pwm, NULL);

    // FR RPM
    msg_fr_rpm.data = MotorFR.CurrentRPM;
    (void)rcl_publish(&pub_fr_rpm, &msg_fr_rpm, NULL);

    // FR PWM: publish actual applied speed in direct mode, PID filtered output otherwise
    if (direct_mode || direct_mode_fr) {
        msg_fr_pwm.data = MotorFR.currentSpeed;
    } else {
        msg_fr_pwm.data = MotorFR.PID.pwr_filt;
    }
    (void)rcl_publish(&pub_fr_pwm, &msg_fr_pwm, NULL);

    // RL RPM
    msg_rl_rpm.data = MotorRL.CurrentRPM;
    (void)rcl_publish(&pub_rl_rpm, &msg_rl_rpm, NULL);

    // RL PWM: publish actual applied speed in direct mode, PID filtered output otherwise
    if (direct_mode || direct_mode_rl) {
        msg_rl_pwm.data = MotorRL.currentSpeed;
    } else {
        msg_rl_pwm.data = MotorRL.PID.pwr_filt;
    }
    (void)rcl_publish(&pub_rl_pwm, &msg_rl_pwm, NULL);

    // RR RPM
    msg_rr_rpm.data = MotorRR.CurrentRPM;
    (void)rcl_publish(&pub_rr_rpm, &msg_rr_rpm, NULL);

    // RR PWM: publish actual applied speed in direct mode, PID filtered output otherwise
    if (direct_mode || direct_mode_rr) {
        msg_rr_pwm.data = MotorRR.currentSpeed;
    } else {
        msg_rr_pwm.data = MotorRR.PID.pwr_filt;
    }
    (void)rcl_publish(&pub_rr_pwm, &msg_rr_pwm, NULL);
}

void publish_debug_string() {
    // Build same format as serial debug line
    int len = 0;
    len += snprintf(debug_buffer + len, sizeof(debug_buffer) - len,
        "--- DEBUG T:%lu ---", millis());

    if (step_test_mode) {
        len += snprintf(debug_buffer + len, sizeof(debug_buffer) - len,
            " STEP_TEST->%d", step_test_target);
    } else if (direct_mode || direct_mode_fl || direct_mode_fr || direct_mode_rl || direct_mode_rr) {
        len += snprintf(debug_buffer + len, sizeof(debug_buffer) - len,
            " DIRECT:%s %d", reverse_direct ? "REV" : "FWD", direct_pwm);
        if (direct_mode_fl) {
            len += snprintf(debug_buffer + len, sizeof(debug_buffer) - len,
                " FL:%s %d", reverse_direct_fl ? "REV" : "FWD", direct_pwm_fl);
        }
        if (direct_mode_fr) {
            len += snprintf(debug_buffer + len, sizeof(debug_buffer) - len,
                " FR:%s %d", reverse_direct_fr ? "REV" : "FWD", direct_pwm_fr);
        }
        if (direct_mode_rl) {
            len += snprintf(debug_buffer + len, sizeof(debug_buffer) - len,
                " RL:%s %d", reverse_direct_rl ? "REV" : "FWD", direct_pwm_rl);
        }
        if (direct_mode_rr) {
            len += snprintf(debug_buffer + len, sizeof(debug_buffer) - len,
                " RR:%s %d", reverse_direct_rr ? "REV" : "FWD", direct_pwm_rr);
        }
    } else if (pid_enabled) {
        len += snprintf(debug_buffer + len, sizeof(debug_buffer) - len, " PID");
    } else {
        len += snprintf(debug_buffer + len, sizeof(debug_buffer) - len, " STOP");
    }

    len += snprintf(debug_buffer + len, sizeof(debug_buffer) - len,
        " Tgt:%d Kp:%.2f Ki:%.2f Kd:%.2f | ",
        target_value, motors[0]->PID.kp, motors[0]->PID.ki, motors[0]->PID.kd);

    for(int id = 0; id < NUMMOTORS; id++) {
        MotorController* m = motors[id];
        int in1 = digitalRead(m->In1Pin);
        int in2 = digitalRead(m->In2Pin);
        const char* dir = (in1 == HIGH && in2 == LOW) ? "FWD" :
                          (in1 == LOW && in2 == HIGH) ? "REV" : "STP";

        len += snprintf(debug_buffer + len, sizeof(debug_buffer) - len,
            "%s RPM:%.1f F:%.1f PWM:%.1f Out:%.1f Dir:%s Pulses:%d | ",
            m->motorPos.c_str(), m->CurrentRPM, m->FilteredRPM,
            m->PID.pwr_filt, m->PID.pwr, dir, m->GetPulses());
    }

    msg_debug.data.size = len;
    (void)rcl_publish(&pub_debug, &msg_debug, NULL);
}

// ============== Main Setup ==============
void setup() {
    Serial.begin(115200);
    delay(500);

    Serial.println("=== RocBot Motor Controller with micro-ROS ===");
    Serial.println("PID Tuning commands: kp<val> ki<val> kd<val> os<val>");
    Serial.println("Step test: step<target>");

    attachInterrupt(digitalPinToInterrupt(MotorFR.EncAPin), ISRReadEncoderFR, RISING);
    attachInterrupt(digitalPinToInterrupt(MotorFL.EncAPin), ISRReadEncoderFL, RISING);
    attachInterrupt(digitalPinToInterrupt(MotorRL.EncAPin), ISRReadEncoderRL, RISING);
    attachInterrupt(digitalPinToInterrupt(MotorRR.EncAPin), ISRReadEncoderRR, RISING);

    Serial.println("Encoder interrupts attached");

    // Initialize micro-ROS (official API)
    setup_micro_ros();
    if (!microros_connected) {
        Serial.println("[ROS] micro-ROS init FAILED — will retry in loop");
        Serial.println("[ROS] Make sure the agent is running:");
        Serial.println("      docker run -it --rm --net=host microros/micro-ros-agent:humble udp4 --port 8888 -v6");
        Serial.print("[ROS] Target agent: ");
        Serial.print(AGENT_IP);
        Serial.print(":");
        Serial.println(AGENT_PORT);
    }

    Serial.println("\n=== Commands ===");
    Serial.println("d<0-255>  - Direct forward");
    Serial.println("D<0-255>  - Direct reverse");
    Serial.println("e         - Encoder debug");
    Serial.println("p         - Enable PID");
    Serial.println("s         - Stop");
    Serial.println("g         - Get state + PID params");
    Serial.println("<num>     - Set target RPM");
    Serial.println("kp<val>   - Set Kp");
    Serial.println("ki<val>   - Set Ki");
    Serial.println("kd<val>   - Set Kd");
    Serial.println("os<val>   - Set output scale (default 10)");
    Serial.println("step<val> - Step test");

    Serial.println("\n=== Ready ===");
}

// ============== Main Loop ==============
void loop() {
    // Handle serial input (fallback control)
    readSerialInput();

    // If not connected, try to reconnect every 3 seconds
    if (!microros_connected) {
        if (millis() - last_agent_check >= 3000) {
            last_agent_check = millis();
            Serial.println("[ROS] Retrying micro-ROS connection...");
            setup_micro_ros();
        }
        // Skip ROS2 processing but keep running motor control
    } else {
        // Process micro-ROS executor
        rclc_executor_spin_some(&executor, RCL_MS_TO_NS(10));
    }

    // Step test mode - change target after delay
    if (step_test_mode && millis() - step_test_start > 5000) {
        step_test_mode = false;
        target_value = 0;
        Serial.println("Step test complete");
    }

    // Always update RPM for all motors at REFRESHRATE interval
    // (regardless of mode — direct mode still needs RPM for diagnostics)
    long currT = micros();
    for(int id = 0; id < NUMMOTORS; id++) {
        float deltaTms = ((float)(currT - prevT[id])) / 1.0e3;
        if (deltaTms >= REFRESHRATE) {
            motors[id]->updateRPM((float)MAXCPR, deltaTms);
            prevT[id] = currT;
        }
    }

    // Per-motor direct PWM (from ROS topics) overrides global direct_mode
    // Motor index: 0=FL, 1=FR, 2=RL, 3=RR
    if (direct_mode_fl || direct_mode_fr || direct_mode_rl || direct_mode_rr || direct_mode) {
        for(int id = 0; id < NUMMOTORS; id++) {
            bool dm = direct_mode;
            int pwm = direct_pwm;
            bool rev = reverse_direct;

            if (id == 0 && direct_mode_fl) {
                dm = true; pwm = direct_pwm_fl; rev = reverse_direct_fl;
            } else if (id == 1 && direct_mode_fr) {
                dm = true; pwm = direct_pwm_fr; rev = reverse_direct_fr;
            } else if (id == 2 && direct_mode_rl) {
                dm = true; pwm = direct_pwm_rl; rev = reverse_direct_rl;
            } else if (id == 3 && direct_mode_rr) {
                dm = true; pwm = direct_pwm_rr; rev = reverse_direct_rr;
            }

            if (dm) {
                motors[id]->SetDirection(!rev);
                motors[id]->SetSpeed(pwm);
            }
        }
    } else if (pid_enabled || step_test_mode) {
        for(int id = 0; id < NUMMOTORS; id++) {
            // Use ROS target if active, otherwise serial target
            int actual_target;
            if (ros_targets_active) {
                if (id == 0) actual_target = (int)ros_target_fl;
                else if (id == 1) actual_target = (int)ros_target_fr;
                else if (id == 2) actual_target = (int)ros_target_rl;
                else actual_target = (int)ros_target_rr;
            } else {
                actual_target = step_test_mode ? step_test_target : target_value;
            }

            motors[id]->controlMotor(actual_target, REFRESHRATE * 1000);
        }
    }

    // Debug output (serial) + ROS publish
    printDebugInfo();
}
