RocaPiedra/RocBot/ESP32/ESP32WiFiConnect/src/MotorController.cpp

// MotorController.cpp
#include "Arduino.h"
#include "MotorController.hpp"
#include "PIDClass.hpp"

MotorController::MotorController(String motorPos, int PWMPin, 
                                int EncAPin, int EncBPin, 
                                int In1Pin, int In2Pin, 
                                float kp, float ki, float kd)
    :motorPos(motorPos), PWMPin(PWMPin),
    EncAPin(EncAPin), EncBPin(EncBPin),
    In1Pin(In1Pin), In2Pin(In2Pin), PID(kp,ki,kd) {
    pinMode(PWMPin, OUTPUT);
    pinMode(EncAPin, INPUT);
    pinMode(EncBPin, INPUT);
    pinMode(In1Pin, OUTPUT);
    pinMode(In2Pin, OUTPUT);
}

void MotorController::readEncoder(){
  // ENCB level determines direction on ENCA rising edge
  // If ENCB is LOW when encoder A rises, count UP (forward)
  // If ENCB is HIGH when encoder A rises, count DOWN (reverse)
  // NOTE: Your encoder is INVERTED compared to default logic
  int b = digitalRead(EncBPin);
  if(b == 0){
    this->pulses--;   // ENCB LOW = forward (was > 0 before)
  }
  else{
    this->pulses++;   // ENCB HIGH = reverse (was == 0 before)
  }
}

int MotorController::GetPulses(){
  return this->pulses;
}

void MotorController::resetPulses(){
  pulses = 0;
}

int MotorController::GetDirection(float power){
  if(power<0){
      this->currentDir = -1; // Backward
      return -1;
    }else{  
      this->currentDir = 1; // Forward
      return 1;
    }
}

void MotorController::SetSpeed(int speed) {
  analogWrite(PWMPin, speed);
  currentSpeed = speed;
}

void MotorController::SetDirection(bool direction) {
  digitalWrite(this->In1Pin, direction ? LOW : HIGH);
  digitalWrite(this->In2Pin, direction ? HIGH : LOW);
  currentDirection = direction;
}

void MotorController::stop() {
  analogWrite(PWMPin, 0);
}

int MotorController::GetTargetSpeed() {
  return currentSpeed;
}

bool MotorController::GetCurrentDirection() {
  return currentDirection;
}

void MotorController::controlMotor(float target_rpm, float deltaTs){
  this->TargetRPM = target_rpm;
  float output = this->PID.CalculateOutput(this->CurrentRPM, target_rpm, deltaTs);
  // motor direction
  this->SetDirection(output>0);
  // signal the motor with the filtered output
  this->SetSpeed(this->PID.FilterOutput(output));

}

void MotorController::updateRPM(float max_cpr, float deltaTms){
  
  this->CurrentRPM = ((float)MotorController::GetPulses()/(float)max_cpr*1000/deltaTms)*60;
  this->FilteredRPM = 0.854*FilteredRPM + 0.0728*CurrentRPM + 0.0728*previous_rpm; //review filter
  this->previous_rpm = CurrentRPM;
  this->resetPulses();

}

String MotorController::GetMotorState(){
  
  return "&" + String(this->motorPos) + 
          ";target:" + String(this->TargetRPM)+
          ";rpm:" + String(this->CurrentRPM)+
          ";rpm_filt:" + String(this->FilteredRPM)+
          ";pwr:" + String(this->currentDir * this->PID.pwr)+
          ";pwr_filt:" + String(this->currentDir * this->PID.pwr_filt);

}
