RocaPiedra/RocBot/ESP32/ESP32WiFiConnect/tools/rocbot_tuner/transport/ros2.py

"""ROS2 transport for micro-ROS agent."""

import asyncio
import time
from typing import Callable, Optional

try:
    import rclpy
    from rclpy.node import Node
    from rclpy.qos import QoSProfile, ReliabilityPolicy, DurabilityPolicy
    from std_msgs.msg import Float64, String
    HAS_RCLPY = True
except ImportError:
    HAS_RCLPY = False

from rocbot_tuner.models import MotorState, ControllerState
from .base import Transport


class _Ros2Bridge(Node):
    """Internal ROS2 node that bridges topics to callbacks."""

    def __init__(self):
        super().__init__("rocbot_tuner")
        self._callbacks: list[Callable[[ControllerState], None]] = []
        # Optional hooks for comm logging (set by the app, never required).
        # debug_handler receives every raw rocbot/debug string from the ESP32.
        self.debug_handler: Optional[Callable[[str], None]] = None

        # Subscribers (simplified to Float64 per motor)
        self._sub_fl_rpm = self.create_subscription(
            Float64, "rocbot/motor_fl/rpm", self._on_fl_rpm, 10)
        self._sub_fl_pwm = self.create_subscription(
            Float64, "rocbot/motor_fl/pwm", self._on_fl_pwm, 10)
        self._sub_fr_rpm = self.create_subscription(
            Float64, "rocbot/motor_fr/rpm", self._on_fr_rpm, 10)
        self._sub_fr_pwm = self.create_subscription(
            Float64, "rocbot/motor_fr/pwm", self._on_fr_pwm, 10)
        self._sub_rl_rpm = self.create_subscription(
            Float64, "rocbot/motor_rl/rpm", self._on_rl_rpm, 10)
        self._sub_rl_pwm = self.create_subscription(
            Float64, "rocbot/motor_rl/pwm", self._on_rl_pwm, 10)
        self._sub_rr_rpm = self.create_subscription(
            Float64, "rocbot/motor_rr/rpm", self._on_rr_rpm, 10)
        self._sub_rr_pwm = self.create_subscription(
            Float64, "rocbot/motor_rr/pwm", self._on_rr_pwm, 10)
        self._sub_debug = self.create_subscription(
            String, "rocbot/debug", self._on_debug, 10)

        # Command publisher MUST be RELIABLE: the ESP32 subscribes with
        # rclc_subscription_init_default (rmw_qos_profile_default = RELIABLE),
        # and DDS silently drops BEST_EFFORT -> RELIABLE (incompatible QoS).
        self._pub_command = self.create_publisher(
            String, "rocbot/command",
            QoSProfile(
                depth=10,
                reliability=ReliabilityPolicy.RELIABLE,
                durability=DurabilityPolicy.VOLATILE,
            ))

        # State
        self._fl_state = MotorState(motor_id="FL")
        self._fr_state = MotorState(motor_id="FR")
        self._rl_state = MotorState(motor_id="RL")
        self._rr_state = MotorState(motor_id="RR")
        self._last_emit = 0.0
        self._emit_interval = 0.05  # 20 Hz
        self._mode = "STOP"
        self._target_value = 0.0
        self._direct_pwm = 0

    def register_callback(self, callback: Callable[[ControllerState], None]):
        self._callbacks.append(callback)

    def _on_fl_rpm(self, msg: Float64):
        self._fl_state.rpm = msg.data
        self._fl_state.rpm_filt = msg.data  # Approximation for now
        self._try_emit()

    def _on_fl_pwm(self, msg: Float64):
        self._fl_state.pwr_filt = msg.data
        # In direct mode the PWM topic may lag; rely on debug string for emission
        if self._mode != "DIRECT":
            self._try_emit()

    def _on_fr_rpm(self, msg: Float64):
        self._fr_state.rpm = msg.data
        self._fr_state.rpm_filt = msg.data
        self._try_emit()

    def _on_fr_pwm(self, msg: Float64):
        self._fr_state.pwr_filt = msg.data
        if self._mode != "DIRECT":
            self._try_emit()

    def _on_rl_rpm(self, msg: Float64):
        self._rl_state.rpm = msg.data
        self._rl_state.rpm_filt = msg.data
        self._try_emit()

    def _on_rl_pwm(self, msg: Float64):
        self._rl_state.pwr_filt = msg.data
        if self._mode != "DIRECT":
            self._try_emit()

    def _on_rr_rpm(self, msg: Float64):
        self._rr_state.rpm = msg.data
        self._rr_state.rpm_filt = msg.data
        self._try_emit()

    def _on_rr_pwm(self, msg: Float64):
        self._rr_state.pwr_filt = msg.data
        if self._mode != "DIRECT":
            self._try_emit()

    def _on_debug(self, msg: String):
        # Parse debug string for mode/pid info and direct PWM values
        import re
        if self.debug_handler:
            try:
                self.debug_handler(msg.data)
            except Exception:
                pass
        state = ControllerState()
        state.timestamp = time.time()

        if "STEP_TEST->" in msg.data:
            state.mode = "STEP_TEST"
            self._mode = "STEP_TEST"
        elif "DIRECT:" in msg.data:
            state.mode = "DIRECT"
            self._mode = "DIRECT"
        elif " PID" in msg.data:
            state.mode = "PID"
            self._mode = "PID"
        elif " STOP" in msg.data:
            state.mode = "STOP"
            self._mode = "STOP"

        kp_match = re.search(r"Kp:([\d.]+)", msg.data)
        ki_match = re.search(r"Ki:([\d.]+)", msg.data)
        kd_match = re.search(r"Kd:([\d.]+)", msg.data)
        tgt_match = re.search(r"Tgt:(-?\d+)", msg.data)
        if kp_match: state.kp = float(kp_match.group(1))
        if ki_match: state.ki = float(ki_match.group(1))
        if kd_match: state.kd = float(kd_match.group(1))
        if tgt_match:
            state.target_value = float(tgt_match.group(1))
            self._target_value = state.target_value

        # Parse global direct PWM from the header (e.g., DIRECT:FWD 100)
        direct_match = re.search(r"DIRECT:(FWD|REV)\s+(\d+)", msg.data)
        if direct_match:
            self._direct_pwm = int(direct_match.group(2))
            # Override the stale PID.pwr_filt with the actual direct PWM
            # so the dashboard shows the real value being applied
            self._fl_state.pwr_filt = float(self._direct_pwm)
            self._fr_state.pwr_filt = float(self._direct_pwm)
            self._rl_state.pwr_filt = float(self._direct_pwm)
            self._rr_state.pwr_filt = float(self._direct_pwm)

        # Parse per-motor direction from the motor blocks
        # Format: FL RPM:28.5 F:28.1 PWM:120.5 Out:12.0 Dir:FWD Pulses:42
        for motor_id, motor_state in [("FL", self._fl_state), ("FR", self._fr_state),
                                      ("RL", self._rl_state), ("RR", self._rr_state)]:
            pattern = rf"{motor_id}\s+RPM:[\d.-]+\s+F:[\d.-]+\s+PWM:[\d.-]+\s+Out:[\d.-]+\s+Dir:(FWD|REV|STP)"
            dir_match = re.search(pattern, msg.data)
            if dir_match:
                motor_state.direction = dir_match.group(1)
            # Also parse per-motor direct PWM if present (e.g., FL:100)
            per_motor_pwm = re.search(rf"{motor_id}:(\d+)", msg.data)
            if per_motor_pwm:
                motor_state.pwr_filt = float(per_motor_pwm.group(1))

        # Attach motor states
        self._fl_state.target_rpm = self._target_value
        self._fr_state.target_rpm = self._target_value
        self._rl_state.target_rpm = self._target_value
        self._rr_state.target_rpm = self._target_value
        state.motors["FL"] = self._fl_state
        state.motors["FR"] = self._fr_state
        state.motors["RL"] = self._rl_state
        state.motors["RR"] = self._rr_state

        if state.motors:
            self._last_emit = time.time()  # prevent _try_emit double-emitting
            for cb in self._callbacks:
                cb(state)

    def _try_emit(self):
        now = time.time()
        if now - self._last_emit < self._emit_interval:
            return

        self._last_emit = now
        state = ControllerState()
        state.timestamp = now
        state.mode = self._mode
        state.target_value = self._target_value
        state.motors["FL"] = self._fl_state
        state.motors["FR"] = self._fr_state
        state.motors["RL"] = self._rl_state
        state.motors["RR"] = self._rr_state

        for cb in self._callbacks:
            cb(state)

    def send_command(self, cmd: str):
        msg = String()
        msg.data = cmd
        self._pub_command.publish(msg)


class Ros2Transport(Transport):
    """ROS2 communication via micro-ROS agent."""

    def __init__(self):
        self._node: Optional[_Ros2Bridge] = None
        self._running = False
        self._spin_task: Optional[asyncio.Task] = None
        # Optional hooks for comm logging (set by the app, never required).
        self.tx_handler: Optional[Callable[[str], None]] = None
        self.debug_handler: Optional[Callable[[str], None]] = None

    @property
    def is_connected(self) -> bool:
        return self._node is not None and rclpy.ok()

    async def connect(self) -> bool:
        if not HAS_RCLPY:
            print("rclpy not available. Install ROS2 Humble or run: sudo apt install ros-humble-rclpy")
            return False

        try:
            # Fix: Only init if context is not already active
            if not rclpy.ok():
                rclpy.init()
            
            self._node = _Ros2Bridge()
            if self.debug_handler:
                self._node.debug_handler = self.debug_handler
            self._running = True
            self._spin_task = asyncio.create_task(self._spin_loop())
            print("ROS2 transport connected")
            return True
        except Exception as e:
            print(f"ROS2 connect failed: {e}")
            return False

    async def disconnect(self):
        self._running = False
        if self._spin_task:
            self._spin_task.cancel()
            try:
                await self._spin_task
            except asyncio.CancelledError:
                pass
        if self._node:
            self._node.destroy_node()
            self._node = None
            
        # Fix: Properly shutdown context to allow reconnection
        if rclpy.ok():
            rclpy.shutdown()
            
        print("ROS2 transport disconnected")

    async def send_command(self, cmd: str):
        if self.tx_handler:
            try:
                self.tx_handler(cmd)
            except Exception:
                pass
        if self._node:
            self._node.send_command(cmd)

    async def read_loop(self, callback: Callable[[ControllerState], None]):
        if self._node:
            self._node.register_callback(callback)
        while self._running:
            await asyncio.sleep(0.1)

    async def _spin_loop(self):
        while self._running and rclpy.ok():
            try:
                rclpy.spin_once(self._node, timeout_sec=0.05)
            except Exception:
                break
            await asyncio.sleep(0.01)
