RocaPiedra/RocBot/ESP32/ESP32WiFiConnect/tools/rocbot_tuner/models.py

"""Data models for RocBot motor controller."""

from dataclasses import dataclass, field


@dataclass
class MotorState:
    """Parsed motor state from one motor."""
    motor_id: str = ""
    target_rpm: float = 0.0
    rpm: float = 0.0
    rpm_filt: float = 0.0
    pwr: float = 0.0
    pwr_filt: float = 0.0
    direction: str = "STP"  # FWD, REV, STP
    pulses: int = 0
    timestamp: float = 0.0  # seconds since start

    @property
    def error(self) -> float:
        return self.target_rpm - self.rpm


@dataclass
class ControllerState:
    """Overall controller state from debug output."""
    elapsed_ms: float = 0.0
    mode: str = "STOP"  # PID, DIRECT, STEP_TEST, STOP
    target_value: float = 0.0
    kp: float = 0.0
    ki: float = 0.0
    kd: float = 0.0
    motors: dict[str, MotorState] = field(default_factory=dict)
