RocaPiedra/RocBot/(commit log)

2024-01-21 Arduino Plotter and initial motor PID testing with filtering
    [MotorParameters.xml]
2024-04-18 repaired motor controller
2024-04-28 New PID class, it turns the execution slow and the controller unresponsive, debug cause or go back
2024-04-28 integrated PID in motor controller
2024-04-28 moved to a multi motor plotter
2024-04-28 integrated in code multi motor control and integrated the motor state update in class methods
2024-04-28 changed motor ID from int to string (FR for Front Right motor) to improve data readability
2024-05-02 multi motor control achieved with one arduino uno and L298N
2024-05-02 multi motor arduino plotter
2026-05-17 bug fix for correct pulse count
    [MotorController.cpp]
2026-05-17 documentation and PID tuning
2026-05-17 new plotter + calibration tool
    [motor_log_20260517_190859.csv]
2026-05-20 move old testing code to tests folder
    [MotorParameters.xml]
2026-06-14 updated logging for calibration
2026-06-14 fixed direct pwm mode over ros 2
    [main_microros.cpp]
2026-09-14 docs: 4-motor omnidirectional pinout (FL/FR/RL/RR) on 2x L298N
    FR 14/22/23/27/26, FL 32/35/34/33/25 (unchanged),
    RR 18/36/39/19/21, RL 13/16/17/4/5 (new).
    Add ESP32 and L298N pinout reference images.
2026-09-14 fix(firmware): always update RPM, report real PWM in direct mode
    - main_debug/main_microros: update RPM every REFRESHRATE window
    regardless of mode so diagnostics work in direct mode; run PID
    on the fixed REFRESHRATE timestep instead of the measured delta.
    - main_microros: publish actual applied PWM (currentSpeed) in
    direct mode instead of stale PID output.
    - tuner ros2 transport: BEST_EFFORT QoS to match micro-ROS,
    parse per-motor direction/PWM from debug string, track mode.
    [app.py, main_debug.cpp, main_microros.cpp, ros2.py]
2026-09-14 chore(firmware): keep only maintained mains in src, archive legacy
    src/ now holds main_microros.cpp (latest, ROS 2) + main_debug.cpp
    (serial tuning) + shared libs. Legacy main_serial.cpp moves to
    test/ next to the hello_microros smoke test.
    platformio.ini: drop DefaultEnv (built the legacy main), fix
    microros env build_src_filter -> src_filter (unknown key was
    ignored, so every main in src/ was compiled). Update AGENTS.md
    build commands and key-file paths.
    [main_serial.cpp]
2026-09-14 feat(firmware): 4-motor omnidirectional support (FL/FR/RL/RR)
    - main_microros.cpp + main_debug.cpp: NUMMOTORS 2 -> 4 with
    RL 13/16/17/4/5 and RR 18/36/39/19/21 (L298N #2), ISRs and
    encoder debug for all wheels. Both envs compile (debug,
    microros).
    - main_microros.cpp: per-motor target_rpm/target_pwm subs and
    rpm/pwm pubs for rl/rr; executor sized for 9 subs; larger
    debug buffer for 4 motor blocks; clearPerMotorDirect helper.
    - MICROROS_README.md: 4-motor topics, WiFi/UDP agent usage.
2026-09-14 feat(tuner): 4-motor support (FL/FR/RL/RR)
    - ros2 transport: subscribe motor_rl/rr rpm/pwm, track 4-motor
    state, parse per-motor direction/PWM from debug string.
    - parser: accept RL/RR (legacy BL/BR normalized to RL/RR).
    - dashboard: 4 motor cards, RL/RR chart colors, calibration and
    auto-tuning selectors default to all 4 motors.
2026-09-14 electric wiring updated for 4 motors. Pending back motors verification.
2026-09-18 updated wiring
2026-09-19 updated pinout schema for the current esp32 being used
